Protonverse-Labs/proton-ai-core-vision-plus/docs/README.md

# Proton AI Core Vision+ Documentation

| Guide | Description |
|---|---|
| [Getting Started](getting-started.md) | Full setup walkthrough: prerequisites, USB connection, build, flash, first boot, first camera test |
| [Hardware Overview](hardware-overview.md) | Verified components and subsystems |
| [Pinout](pinout.md) | GPIO assignments and bus map, sourced from firmware and cross-checked against the schematic |
| [Camera Guide](camera.md) | Camera init, capture, streaming, resolutions, known limitations |
| [Firmware Guide](firmware.md) | Firmware architecture, build settings, serial command reference |
| [Flashing Guide](flashing.md) | Build and flash instructions in detail |
| [Troubleshooting](troubleshooting.md) | Known failure modes and fixes |
| [FAQ](faq.md) | Common questions |
| [Project Status](project-status.md) | What is verified today, transparently |
| [Roadmap](roadmap.md) | Available now / in progress / planned |
| [Demo Recording Checklist](DEMO_RECORDING_CHECKLIST.md) | What the next hardware demo recording will show |

All technical claims in these documents are sourced from the working firmware, the approved schematic, component datasheets, or explicit verification from the Proton AI Core Vision+ team. Anything that could not be verified against those sources is marked `TODO: Verification required` rather than guessed.
