Protonverse-Labs/proton-ai-core-vision-plus/assets/diagrams/schematic-overview.png

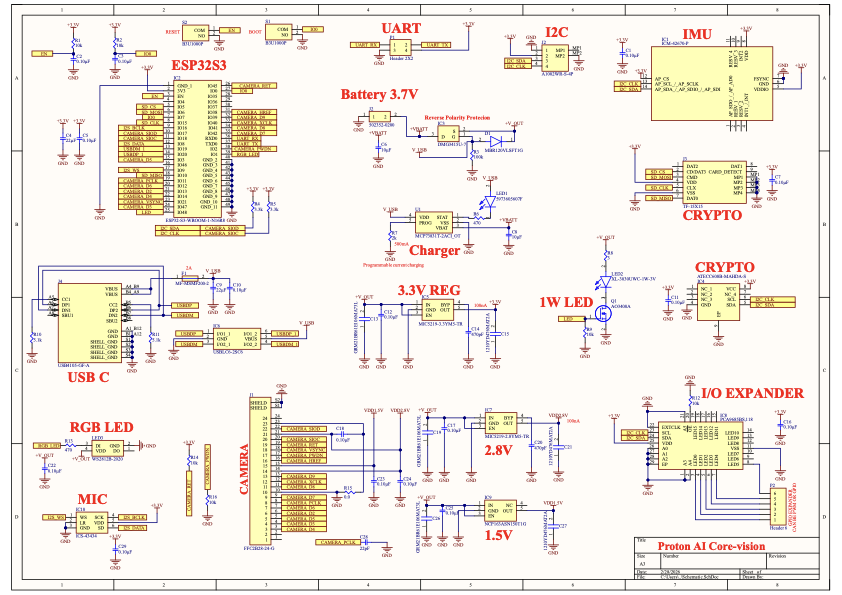
assets/diagrams/schematic-overview.png
