Protonverse-Labs/proton-ai-core-vision-plus/hardware/Schematic.pdf

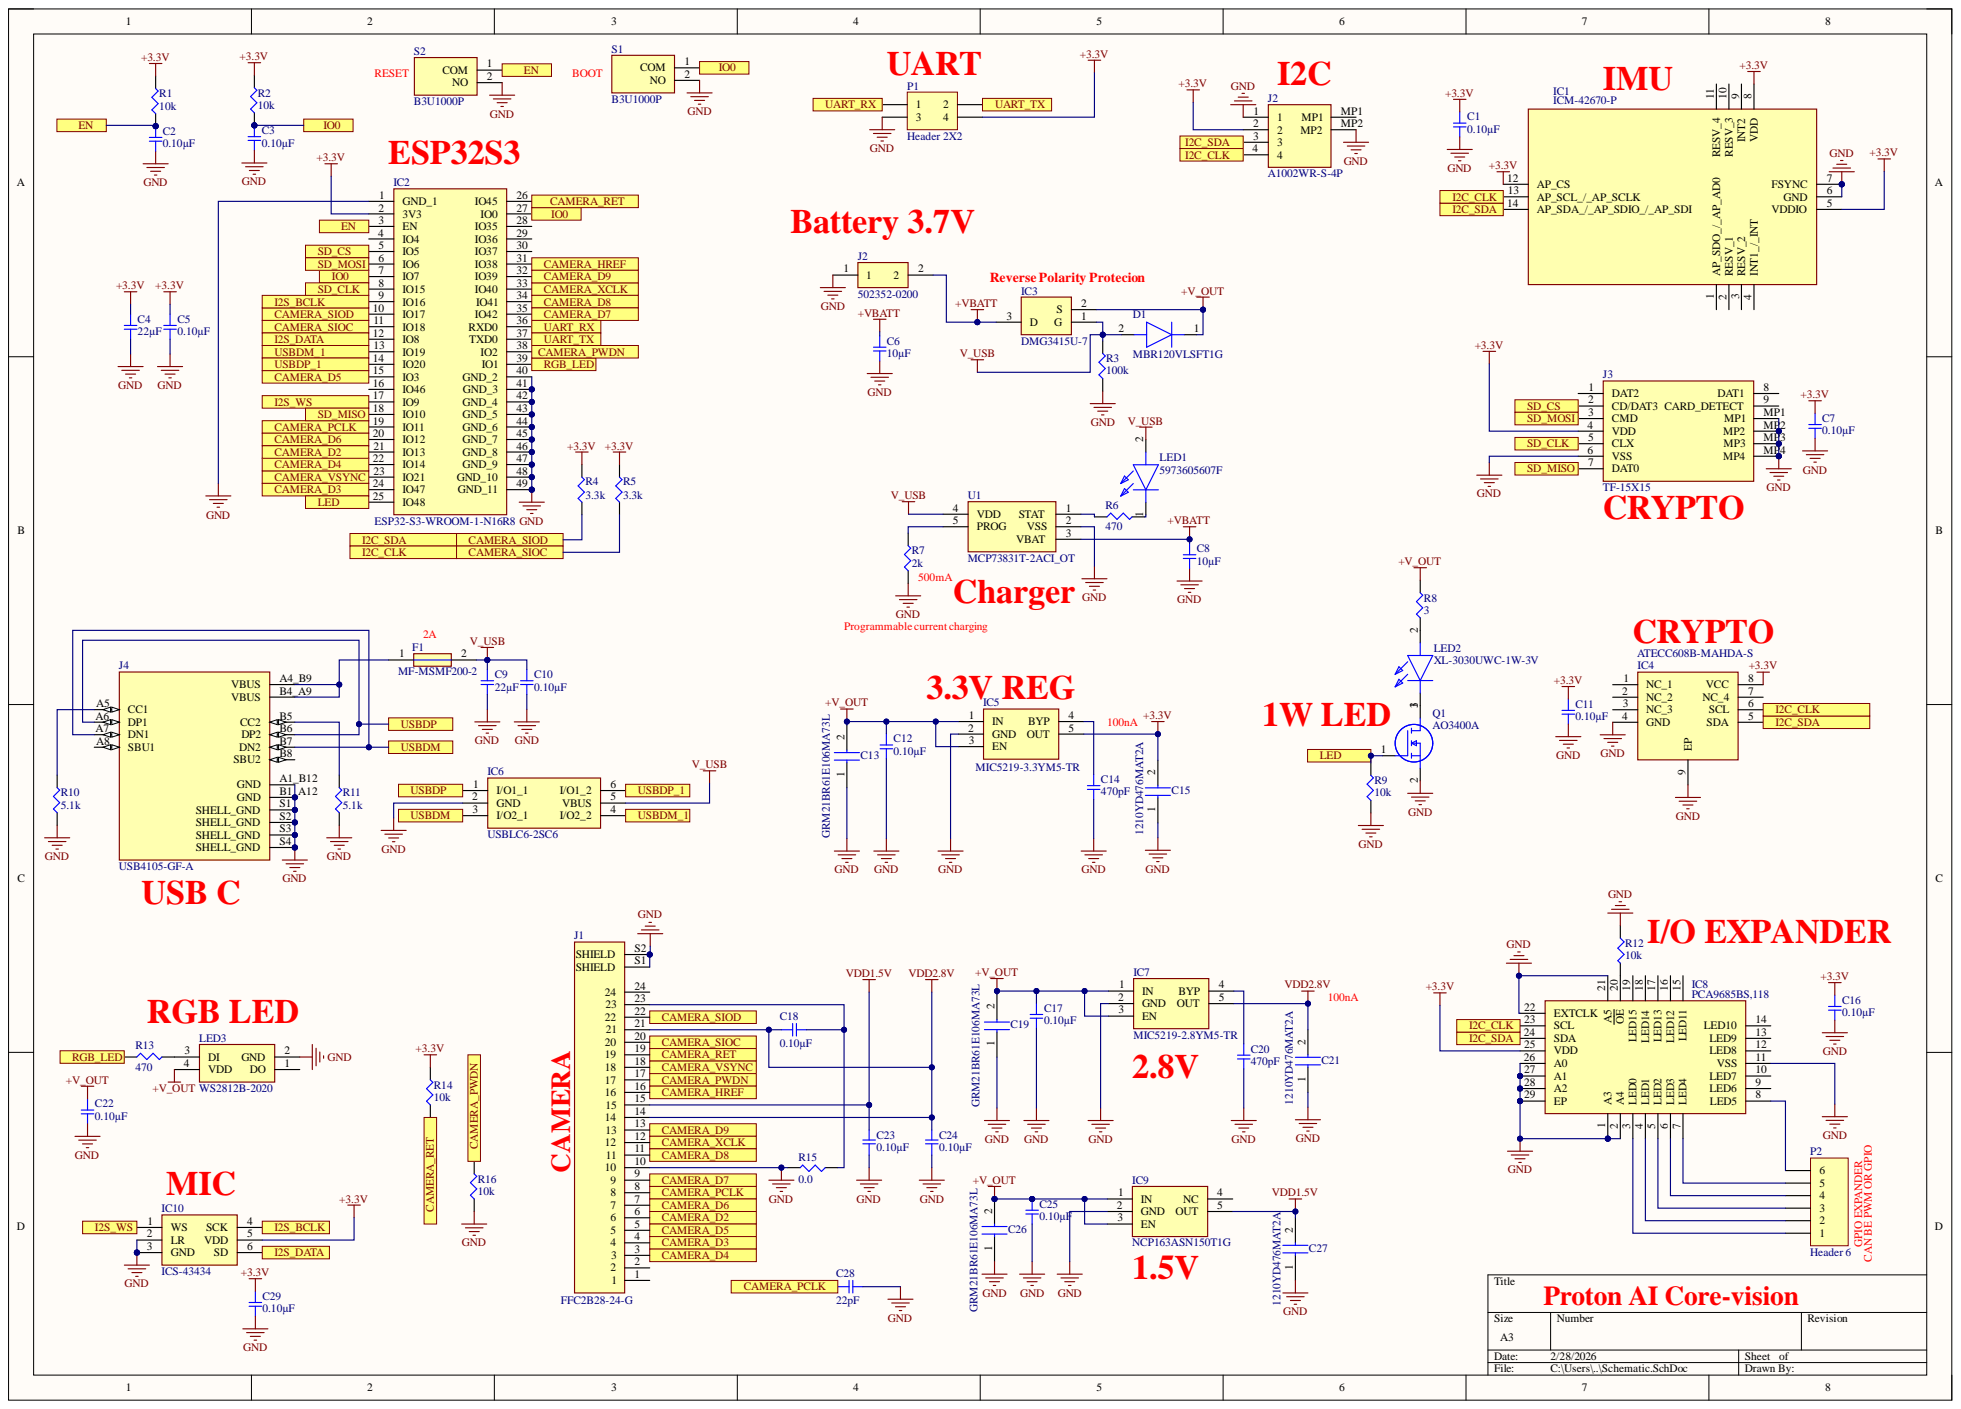
[picture p4: page 1]

I2C_SDA | CAMERA_SIOD
I2C_CLK | CAMERA_SIOC

USBDP | GND 2 | USBDP_1

Title
Proton AI Core-vision
