Protonverse-Labs/proton-ai-core-vision-plus/(commit log)

2026-08-10 Initial public repository: Proton AI Core Vision+
    Working Arduino firmware (sanitized), hardware documentation, approved
    schematic, real board photos, extracted examples, and full docs set for
    the Proton AI Core Vision+ ESP32-S3 camera board.
    Manufacturing source files, the full production BOM, and Protonverse
    Studio source code are intentionally not included.
2026-08-23 Correct hardware licence from CERN-OHL-S to CERN-OHL-P v2
    CERN-OHL-S requires Complete Source on conveyance of a product,
    which is incompatible with withholding layout and production files.
    CERN-OHL-P has no such requirement. Also adds an explicit trademark
    reservation.
    [BOM.csv]
